taguko/tp4056-multicell-charger/img/prototype1.jpg

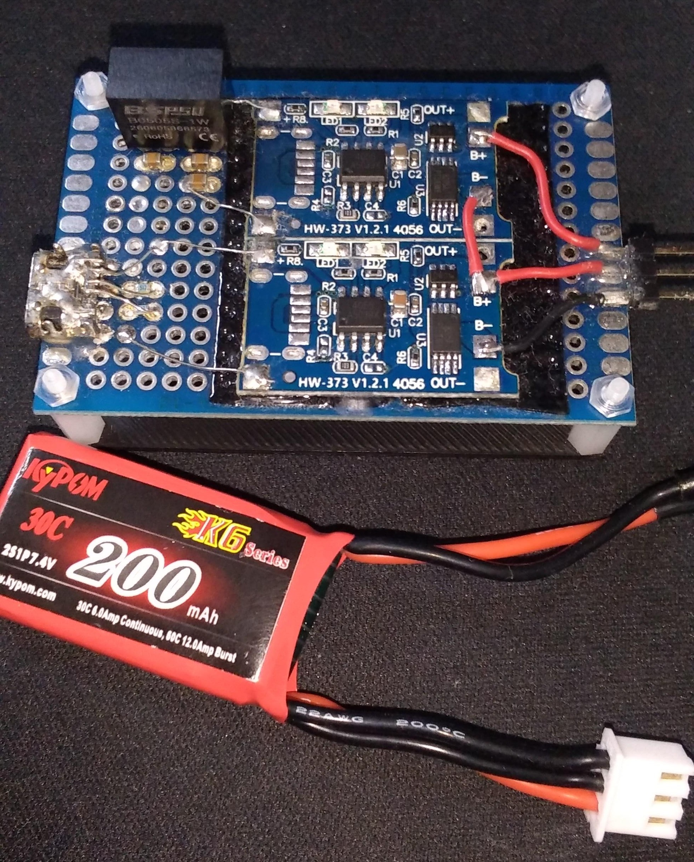
img/prototype1.jpg
