taguko/tp4056-multicell-charger/tp4056-multicell-charger.pdf

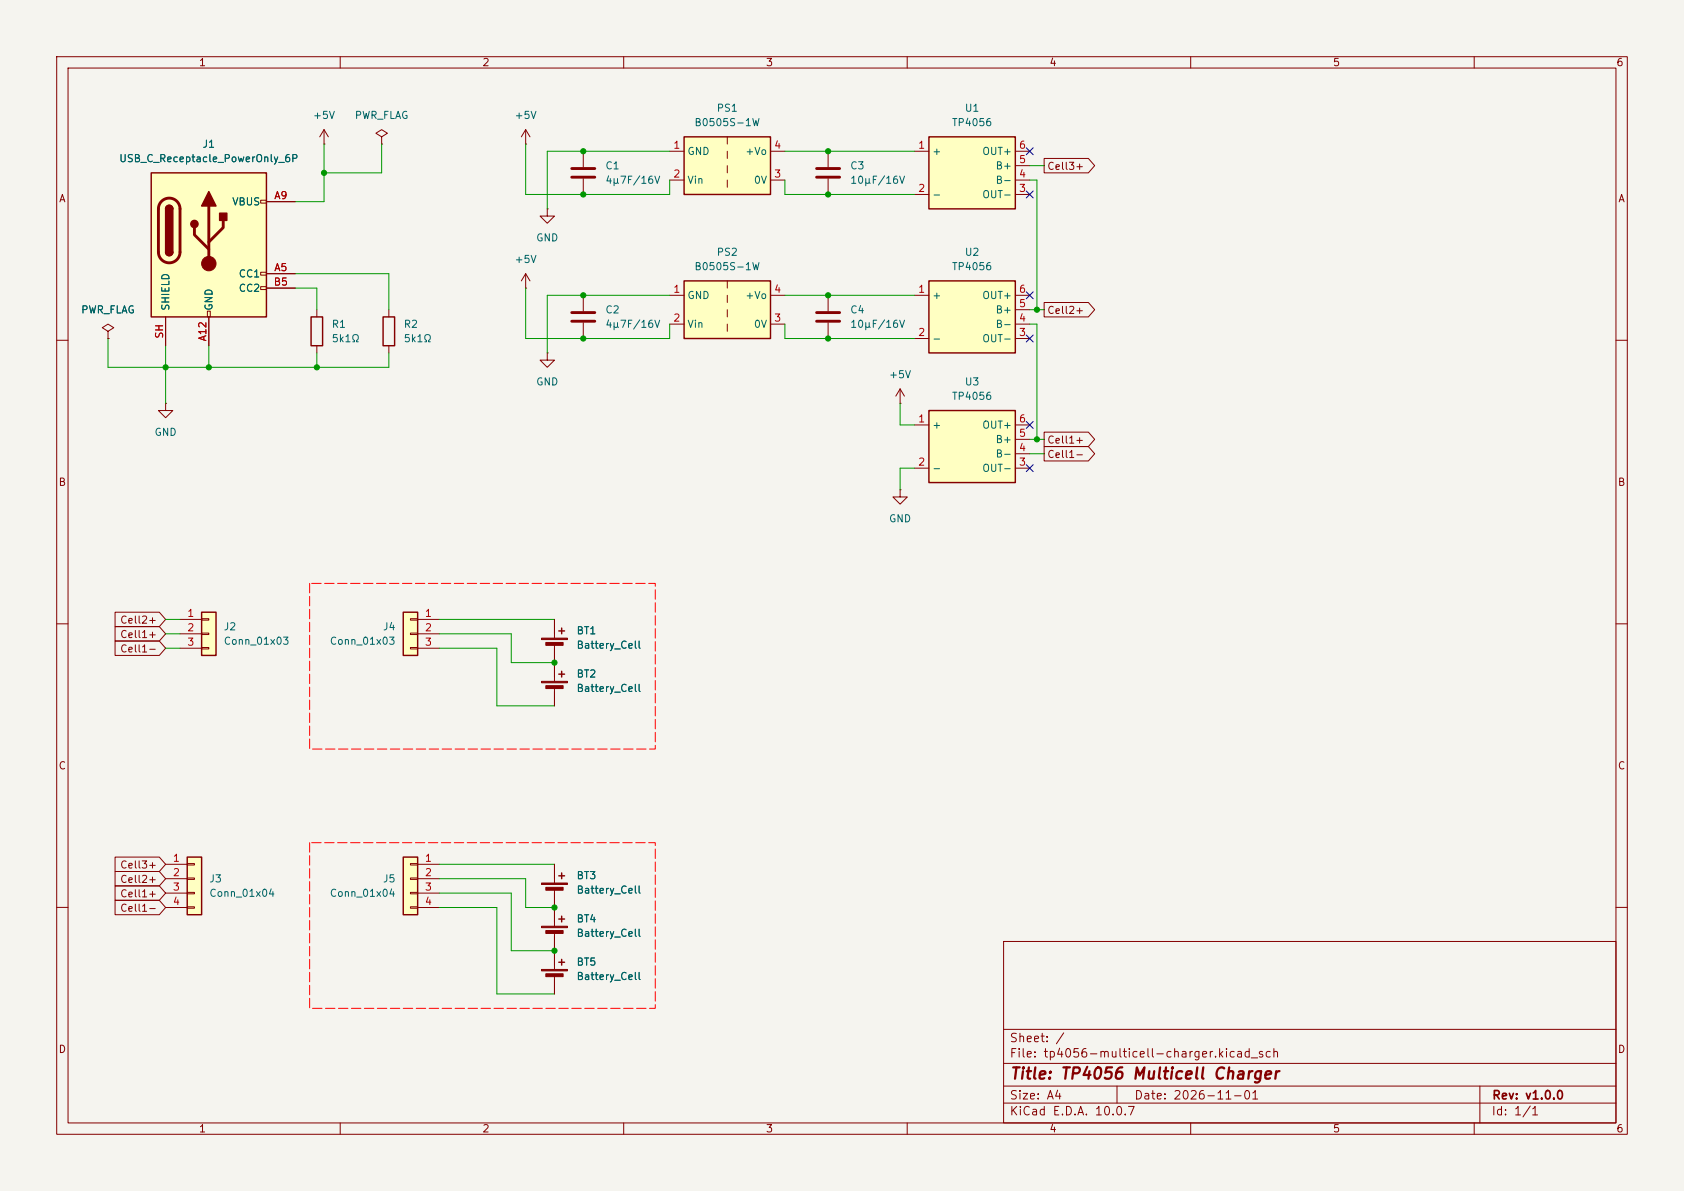
[picture p3: page 1]

Size: A4 | Rev: v1.0.0
KiCad E.D.A. 10.0.7 | Id: 1/1
