taguko/tp4056-multicell-charger/tp4056-multicell-charger.kicad_pcb

## KiCad design tp4056-multicell-charger.kicad_pcb (2026-11-01)

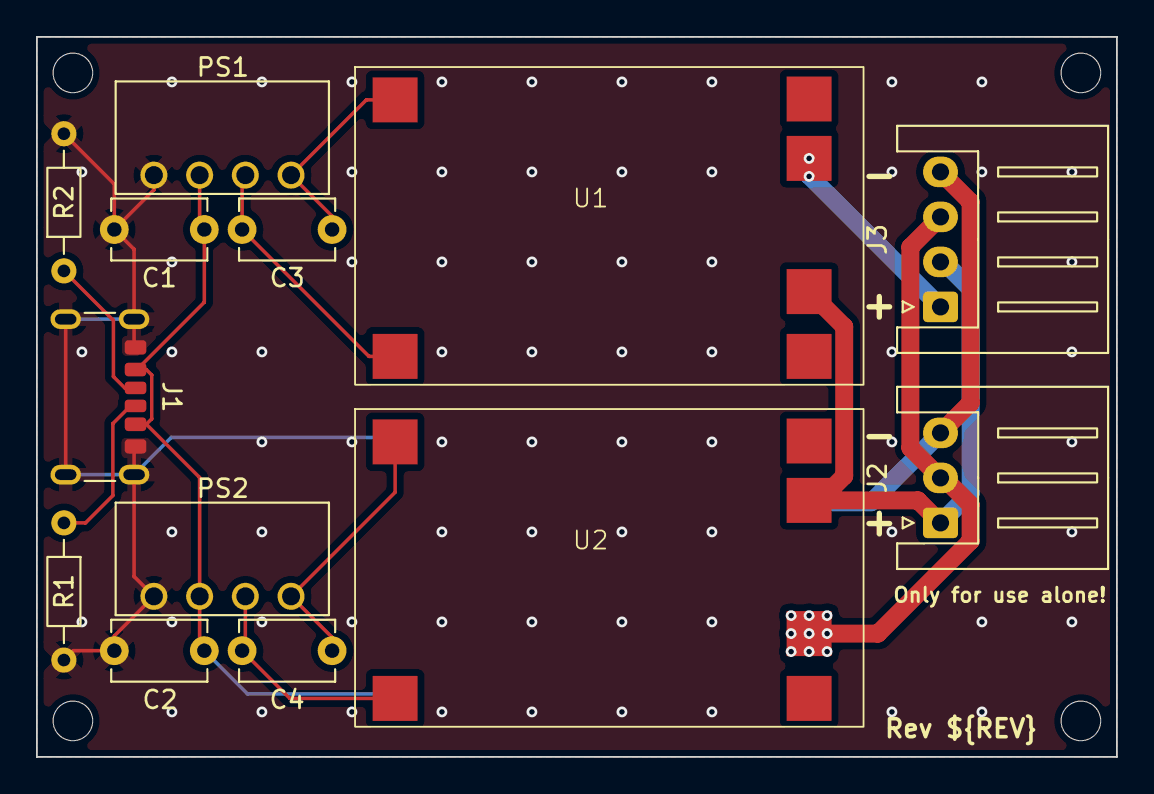
[picture p4: board tp4056-multicell-charger.kicad_pcb from above]

Board: 2 copper layers, 60.0 x 40.0 mm, 14 parts (1 on the bottom side), 12 nets.

Parts:
C1, C2: 4μ7F/16V; C_Disc_D5.1mm_W3.2mm_P5.00mm
C3, C4: 10μF/16V; C_Disc_D5.1mm_W3.2mm_P5.00mm
J1: USB_C_Receptacle_PowerOnly_6P; USB_C_Receptacle_GCT_USB4125-xx-x_6P_TopMnt_Horizontal
J2: Conn_01x03; JST_XH_S3B-XH-A_1x03_P2.50mm_Horizontal
J3: Conn_01x04; JST_XH_S4B-XH-A_1x04_P2.50mm_Horizontal
PS1, PS2: B0505S-1W; Converter_DCDC_B_S-1WR3 Series
R1, R2: 5k1Ω; R_Axial_DIN0204_L3.6mm_D1.6mm_P7.62mm_Horizontal
U1, U2, U3: TP4056; TP4056_Module_SMD

Connections:
+5V: C1.2, C2.2, J1.A9 (VBUS), J1.B9 (VBUS), PS1.2 (Vin), PS2.2 (Vin), U3.1 (+)
Cell1+: J2.2, J3.3, U2.4 (B-), U3.5 (B+)
Cell1-: J2.3, J3.4, U3.4 (B-)
Cell2+: J2.1, J3.2, U1.4 (B-), U2.5 (B+)
Cell3+: J3.1, U1.5 (B+)
GND: C1.1, C2.1, J1.A12 (GND), J1.B12 (GND), J1.SH (SHIELD), PS1.1 (GND), PS2.1 (GND), R1.2, R2.2, U3.2 (-)
unnamed: J1.A5 (CC1), R2.1
unnamed: J1.B5 (CC2), R1.1
unnamed: C3.1, PS1.3 (0V), U1.2 (-)
unnamed: C3.2, PS1.4 (+Vo), U1.1 (+)
unnamed: C4.1, PS2.3 (0V), U2.2 (-)
unnamed: C4.2, PS2.4 (+Vo), U2.1 (+)
