taguko/tp4056-multicell-charger/(commit log)

2026-10-15 Fix filename case for README.md
2026-10-15 fixed title *.pdfを除外
    [tp4056-multicell-charger.kicad_sch]
2026-10-15 add prototype img
2026-10-15 add prototype img to README.md
2026-10-17 Update README with battery capacity, charging current, and disclaimer
    Added sections on recommended battery capacity and charging current, along with a disclaimer regarding the project's intended use and risks associated with lithium battery charging.
2026-10-17 Update flowchart connections in README.md
2026-10-17 Fix flowchart label for ISO1 in README.md
2026-10-17 Fix flowchart syntax in README.md
2026-10-17 Update flowchart syntax in README.md
2026-10-18 add circuit diagram pdf
2026-10-18 Update charging current information in README
    Clarified charging current details in README.
2026-10-26 footprint edit
    [tp4056-multicell-charger.kicad_pcb, tp4056-multicell-charger.kicad_sch]
2026-10-26 add REVISION value
    [tp4056-multicell-charger.kicad_pcb, tp4056-multicell-charger.kicad_sch]
2026-10-27 Add BOM section to README
    Added BOM section with a link to PartsCabi.net.
2026-10-27 fix sch
    [tp4056-multicell-charger.kicad_sch]
2026-10-28 add via to Cell3+
    [tp4056-multicell-charger.kicad_pcb]
